bambera/230box/documents/Dashboard.pdf

INDICADORES: ( Luz fija )
Led Blanco: Funciones automaticas activadas.
Led Verde*: Fuente externa* con voltaje correcto detectado. Led Amarillo*: Salia de corriente activada.
Led Verde Home: Vivienda alimentada.
Led Rojo: Inversor encendido.
Led Azul: Cargador de 220V de batería alimentado.

ERRORES: ( Luz intermitente )
1.- Led Blanco intermitente: Comunicación interrumpida.
2.- Leds Verde* y Amarillo* intermitentes simultaneos: Voltaje fuera de rango. 3.- Leds Verde* y Amarillo* intermitentes alternados: Fuente desconocida.
4.- Leds Verde Right intermitente y Left fijo (o viceversa): Dos fuentes externas. 5.- Led Verde* intermitente y led Rojo fijo: Fuente externa e inversor encendido. 6.- Led Verde Home intermitente: Fuente desconocida en home.
7.- Led Rojo intermitente: Encendido del inversor no es posible.

( * = Derecho o izquierdo )

ON

1 23 4 5 6 7

1 Modo automático.
2 Fuente conectada en el lado derecho. 3 Fuente conectada en el lado izquierdo. 4 Alimentar enchufe externo derecho.
5 Alimentar enchufe externo izquierdo. 6 Alimentar vivienda.
7 Alimentar cargador 220V de baterias.

Modo AUTOMATICO: El sistema toma las decisiones necesarias 1 ON. El resto de interruptores en OFF.

ATENCION: Riesgo eléctrico.
No realizar ninguna maniobra manual sin no se ha leido antes el manual.
Antes de hacer una maniobra posicionar todos los interruptores en OFF. Posicionar en ON de izquierda a derecha.

ON

1 2 3 4 5 6 7

ON

1 2 3 4 56 7

ON

1 2 3 4 56 7
ON

1 2 3 4 5 6 7

Si queremos una FUENTE en el enchufe EXTERIOR.
1.- Posicionar todos los interruptores en OFF.
2.- El inversor debe estar desconectado.
3.- El cargador 220V de baterias puede estar conectado 7 ON. 4.- Si le fuente va ha ser conectada en el lado derecho 2 ON. 5.- Si le fuente va ha ser conectada en el lado izquierdo 3 ON. 6.- Si queremos alimentar la vivienda 6 ON.
7.- Si queremos alimentar el enchufe externo del otro lado, maxima atención, si 2 ON 5 ON, si 3 ON 4 ON.
8.- NUNCA posicionar simultaneamente (2 y 4), o (2 y 5).

ON

1 23 4 5 6 7
ON

12 3 4 5 6 7
ON

12 3 4 5 6 7

ON

1 23 4 5 6 7

Si necesitamos 220V pero no tenemos una fuente externa, antes de encender el INVERSOR.
1.- POSICIONAR todos los interruptores en OFF.
2.- Si queremos alimentar la vivienda 6 ON.
3.- Para alimentar el enchufe externo del lado derecho 4 ON. 4.- Para alimentar el enchufe externo del lado izquierdo 5 ON. 5.- Se pueden activar simultaneamente (4, 5 y 6).
5.- NUNCA activar el cargador 220V de baterias (7).
6.- NUNCA puede conectarse una fuente externa.

-.1.-

-.2.-

-.3.-

-.4.-

APAGAR
INVERSOR

O

ON

1 2 3 4 5 6 7

-.5.- | ON

1 2 3 4 5 6 7

-.7.- ON

1 2 3 4 56 7

-.7.-
O

ON

1 2 3 4 5 6 7

-.6.-

-.6.-
ENCENDER
INVERSOR

-.1.-

-.2.-

-.3.-

-.4.- | ON
| 1 2 3 4 5 6 7

-.5.-

!
