bambera/230box/documents/ElectricScheme/Electric_Scheme1-2.pdf

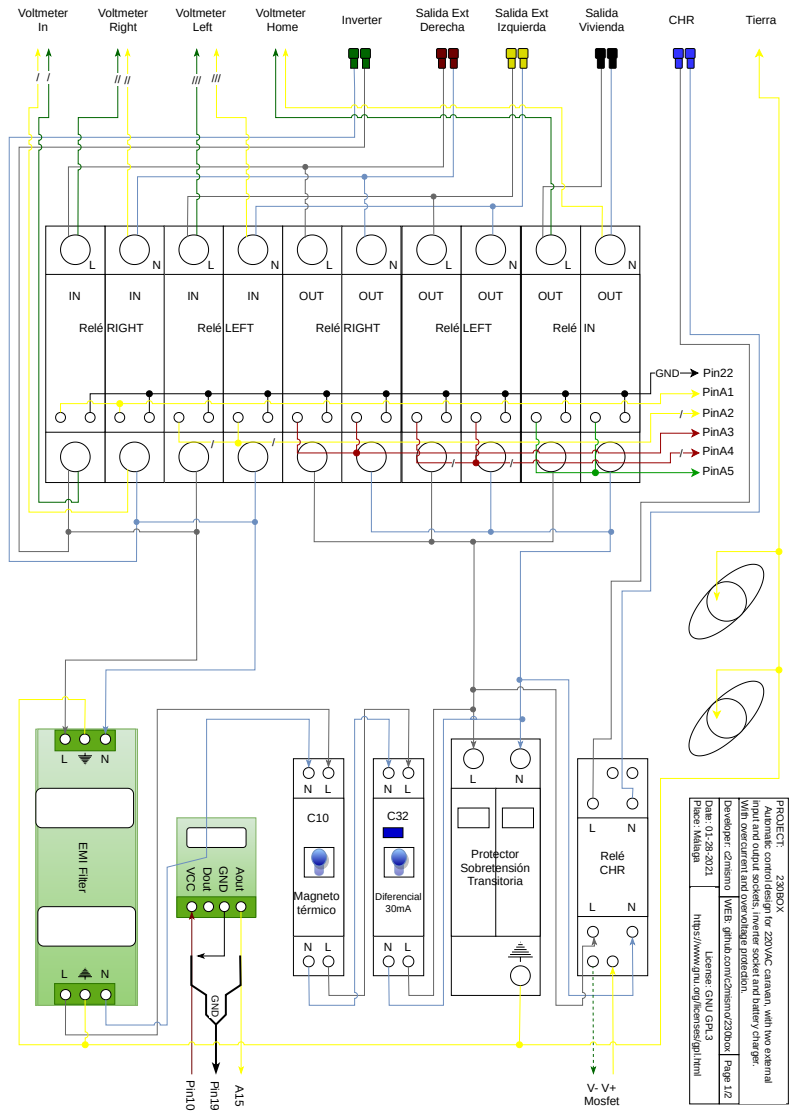
[picture p1: page 1]
OUT; Relé RIGHT; Relé LEFT; Relé IN; EMI Filter; Protector Sobretensión Transitoria; Voltmeter Right; Salida Ext Derecha; Salida Ext Izquierda; Salida Vivienda; Voltmeter Left; Voltmeter; Inverter; CHR; V- V+ Mosfet; Tierra; PinA1; Pin22; PinA2 PinA3; PinA4; PinA5; Relé CHR; Magneto térmico; Diferencial 30mA; VCC; Dout; GND; Aout; Pin10; Pin19; Voltmeter Home; PROJECT: 230BOX; Place: Málaga

Date: 01-28-2021 License: GNU GPL3

input and output sockets, inverter socket and battery charger. Developer: c2mismo With overcurrent and overvoltage protection. WEB: github.com/c2mismo/230box

Automatic control design for 220VAC caravan, with two external

https://www.gnu.org/licenses/gpl.html
