bambera/230box/230box/230box.ino

 /*
 * State testing, developer c2mismo 2019.
 * License GNU, see at the end.
 */

//         //////////\\\\\\\\\\
//        //   LIBRARY CONF   \\
//       ////////////\\\\\\\\\\\\

#include <Arduino.h>
#include "Leds.h"

//       \\\\\\\\\\\\////////////
//        \\ END LIBRARY CONF //
//         \\\\\\\\\\//////////

//         /////////\\\\\\\\
//        //     PINS      \\
//       ///////////\\\\\\\\\\

const int signalOn = A0;
const int signalHome = 5;

const int signalAmper = A8;
const int signalLeft = A9;
const int signalRight = A10;
const int signalIn = A11;

const int ledLeftIn = 40;
const int ledLeftOut = 41;
const int ledRightIn = 42;
const int ledRightOut = 43;
const int ledInverter = 44;
const int ledCHR = 45;
const int ledHome = 46;
const int ledAutomatic = 47;

Leds leds (ledLeftIn, ledLeftOut, ledRightIn, ledRightOut, ledInverter, ledCHR, ledHome, ledAutomatic);

const int releRightIn = A1;
const int releLeftIn = A2;
const int releRightOut = A3;
const int releLeftOut = A4;
const int releHome = A5;
const int releCHR = A7;
const int reles[7] = {releRightIn, releLeftIn, releRightOut, releLeftOut, releHome, releCHR};



//       \\\\\\\\\\\//////////
//        \\    END PINS   //
//         \\\\\\\\\////////

//         /////////\\\\\\\\
//        //   VARIABLES   \\
//       ///////////\\\\\\\\\\

//       \\\\\\\\\\\//////////
//        \\ END VARIABLES //
//         \\\\\\\\\////////

void setup(){
  Serial.begin(9600);

  pinMode(signalOn, INPUT);
  pinMode(signalHome, INPUT_PULLUP);

  pinMode(signalAmper, INPUT);

  pinMode(releRightIn, OUTPUT);
  pinMode(releLeftIn, OUTPUT);
  pinMode(releRightOut, OUTPUT);
  pinMode(releLeftOut, OUTPUT);
  pinMode(releHome, OUTPUT);
  pinMode(releCHR, OUTPUT);

  leds.blinkOn();
}

void loop(){
}

//         /////////\\\\\\\\
//        //   FUNCTIONS   \\
//       ///////////\\\\\\\\\\



//       \\\\\\\\\\\//////////
//        \\ END FUNCTIONS //
//         \\\\\\\\\////////

/*
  License:

    Copyright (C) 2019  c2mismo.

    This file is part of 230box.

    230box is free software: you can redistribute it and/or modify
    it under the terms of the GNU General Public License as published by
    the Free Software Foundation, either version 3 of the License, or
    (at your option) any later version.

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
    You can download a full copy of 230box at <https://github.com/c2mismo>.
 */
