bambera/230box/(commit log)

2019-07-19 Add control frecuency for motor DC
2019-07-19 Maked AnalogWritePlus lib
    AnalogWritePlus frecuency control for PWM optocoupled.
    timer == Timer/counter by Atmel
    For UNO I advise Timer 1 (not is possible with Servo, Toner, etc...)
    fanMin and fanMax for calibrate fan.
    Need use to begin and config frecuency
    TOP = 320; 24.883 MHz; PWM 0~320
    TOP = 400; 19.906 MHz
    TOP = 200; 39.813 MHz
    TOP = 100; 79.626 MHz
    Use with write as percentage (0~100%)
    pin = only fron his timer
    value = percentage
    Created by c2mismo 19/07/19
    Released into the public domain.
2019-12-18 Created a example AnalogWritePlus for calibrate motors
2019-12-20 Not changed. The first commit with Arduino Pro IDE.
    Prube Arduino Pro IDE. :)
2019-12-20 Mejorada la descripcion. Start new way Calibrated.
    Descripcion muy mejorada.
    The new way calibrated se crea como ejemplo de AnalogWritePlus.
2019-12-23 Add DS18B20_buscar_identificador
    Enumera los sensores DS18B20.
    Muestra sus identificadores unicos.
    Muestra la temperatura registrada de cada sensor enumerados.
    La enumeracion corresponde al identificador.
2019-12-23 Add DS18B20_con_identificador.ino
    Despues de buscar el identificador se comprueba con este sketch.
    Se puede configurar la resolucion.
2019-12-25 Make DS18B20_example
    Print this:
    tmpSensorFlo: 24.25 ºC
    tmpSensorInt: 2425 ºC
    tmpSenDirFlo: 24.00 ºC
    temperaturaSensor: 24.25 ºC
    Seeing the results we decided to do three functions:
    1 - Read sensor with decimals
    2 - Read sensor without decimals to make calculations
    3 - Convert integers to decimals
2019-12-25 Created and checked the functions for DS18B20
    We created an checked 4 functions for used whith DS18B20.
    Function errorSensor check if the sensor has an error.
    Function readFloat returns the temperature readings.
    Fuction readInt returns the temperature readings who integer,
    to avoid possible mistakes when working with float numbers.
    Function result returns the result of operations as a float number.
2019-12-26 Maked fuctions for DS18B20
    Created and checked the functions for DS18B20
    We created and checked 4 functions to use with DS18B20.
    Fuction readInt returns the temperature readings how integer,
    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
2019-12-27 Add notes about control temperature and PID
2019-12-28 Maked and tested 230box with fan simple controller with temp
    We have decided not to use a PID controller.
    1. Because we can't keep maintaining a specific temperature.
    2. Excessive changes in temperature are not expected.
    3. It remains to experiment and determine the thermal response of the
    components.
    The temperature controller is configured as follows:
    1. We will treat the data as integers from the beginning, because the
    map function with decimals has a not very clear answer.
    2. The chaining is not done until it reaches 45ºC (4500).
    3. The engine starts at 4% ±.
    3. 100% or maximum engine power is at 70 ° C (7000).
    4. The engine will not stop until it reaches 40ºC, with a timely
    hystere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
2020-12-01 Init led config
2020-12-03 array led
2020-12-06 Init Leds Library
2020-12-06 INIT volt branch
2020-12-06 INIT volt
2020-12-08 Add test Voltmeter
2020-12-08 Parte interior de puerta, sin terminar
2020-12-09 Restructural Voltmeter
2020-12-09 INIT Voltmeter drawio
2020-12-09 INIT workflow process Voltmeter.h
2020-12-10 Edit Voltmeter
2020-12-10 INIT Leds drawio
2020-12-11 Make news modes for canBus
2020-12-12 Add libs SPI can mcp2515
2020-12-12 Add send msg voltimeters & status reles
2020-12-13 Relé Init LN cables
2020-12-24 Add Ammeter canBus
2020-12-24 Clean Voltmeter
2021-01-25 Add Voltmeter more chn
2021-01-25 Del old schematics
2021-01-25 Add UML Scheme for Use Case
2021-01-25 Use case pdf & fixed date
2021-01-28 INIT main flowchart
2021-01-28 Edit and print pdf
2021-01-31 INIT leds indications
2021-02-01 Page format leds indications
2021-02-01 leds indicatios pdf
2021-02-02 Add debounce to Voltmeter
2021-03-08 Edit schematics
